bin2ai/Senior_Design/notes/ATMEGA328_Pinout_SeniorDesign.xlsx

ATMEGA328
PIPD |  |  | TQFP
# | type | our use | # | type | our use
1 | RESET | RESET | 1 | D | B en
2 | RXD | B TX | 2 | D | B Key
3 | TXD | B RX | 3 | GND | GND
4 | D | B en | 4 | VCC | VCC
5 | D | B state | 5 | GND | GND
6 | D | B Key | 6 | VCC | VCC
7 | VCC | VCC | 7 | XTAL | XTAL
8 | GND | GND | 8 | XTAL | XTAL
9 | OSC | OSC | 9 | D | LED Din
10 | OSC | OSC | 10 | D | Scale Dout
11 | D | Scale Dout | 11 | D | Scale clck
12 | D | Scale clck | 12 | D | touch
13 | D | touch | 13 | D | touch
14 | D | touch | 14 | D | touch
15 | D | touch | 15 | MOSI | ISP
16 | D | LED Din | 16 | MISO | ISP
17 | MOSI | ISP | 17 | SCK | ISP
18 | MISO | ISP | 18 | AVCC | AVCC
19 | SCK | ISP | 19 | ADC | ???
20 | VCC | VCC | 20 | AREF | AREF
21 | AREF | AREF | 21 | GND | GND
22 | GND | GND | 22 | ADC | motion
23 | ADC | motion | 23 | ADC | ambient
24 | ADC | ambient | 24 | ADC | current monitor
25 | ADC | current monitor | 25 | ADC | current monitor
26 | ADC | current monitor | 26 | ADC | ???
27 | SDA | LCD SDA | 27 | SDA | LCD SDA
28 | SCL | LCD SCL | 28 | SCL | LCD SCL
 |  |  | 29 | RESET | RESET
 |  |  | 30 | RX | B TX
 |  |  | 31 | TX | B RX
 |  |  | 32 | D | B state
