bin2ai/Senior_Design/screenshots/_12V_Power_4-24.GIF

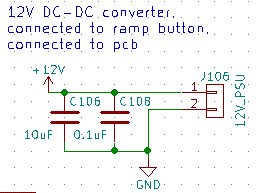
screenshots/_12V_Power_4-24.GIF
