bin2ai/Senior_Design/screenshots/Bluetooth_4-24.GIF

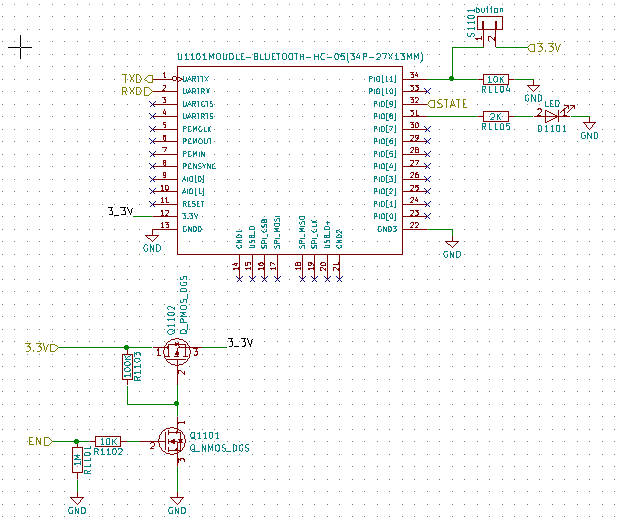
screenshots/Bluetooth_4-24.GIF
