bin2ai/Senior_Design/screenshots/buzzer_4-24.GIF

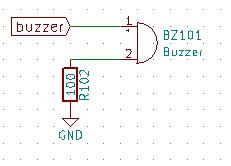
screenshots/buzzer_4-24.GIF
