bin2ai/Senior_Design/screenshots/CurrentSense_4-24.GIF

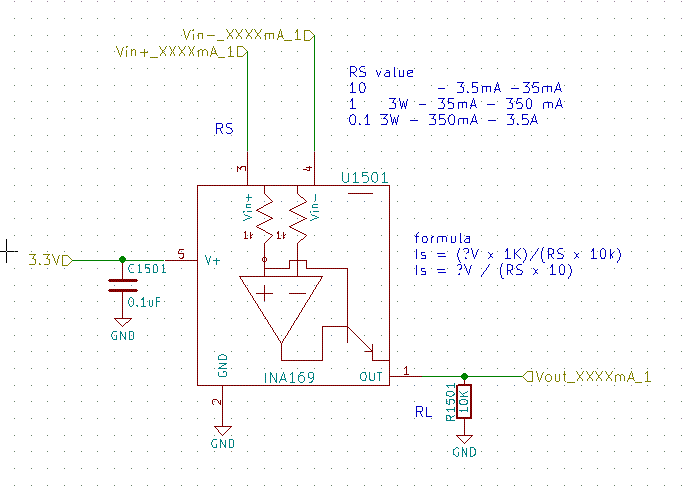
screenshots/CurrentSense_4-24.GIF
