bin2ai/Senior_Design/screenshots/ISP_4-24.GIF

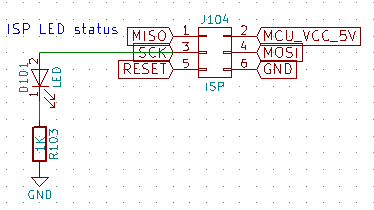
screenshots/ISP_4-24.GIF
