bin2ai/Senior_Design/screenshots/LCD_Display_4-24.GIF

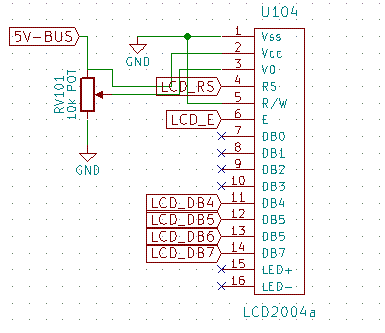
screenshots/LCD_Display_4-24.GIF
