bin2ai/Senior_Design/screenshots/LED_Single_4-24.GIF

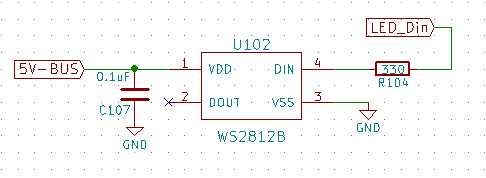
screenshots/LED_Single_4-24.GIF
