bin2ai/Senior_Design/screenshots/LED_Strip_4-24.GIF

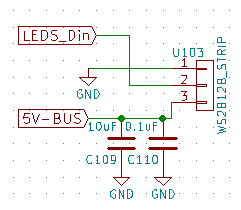
screenshots/LED_Strip_4-24.GIF
