bin2ai/Senior_Design/screenshots/loadCell_4-24.GIF

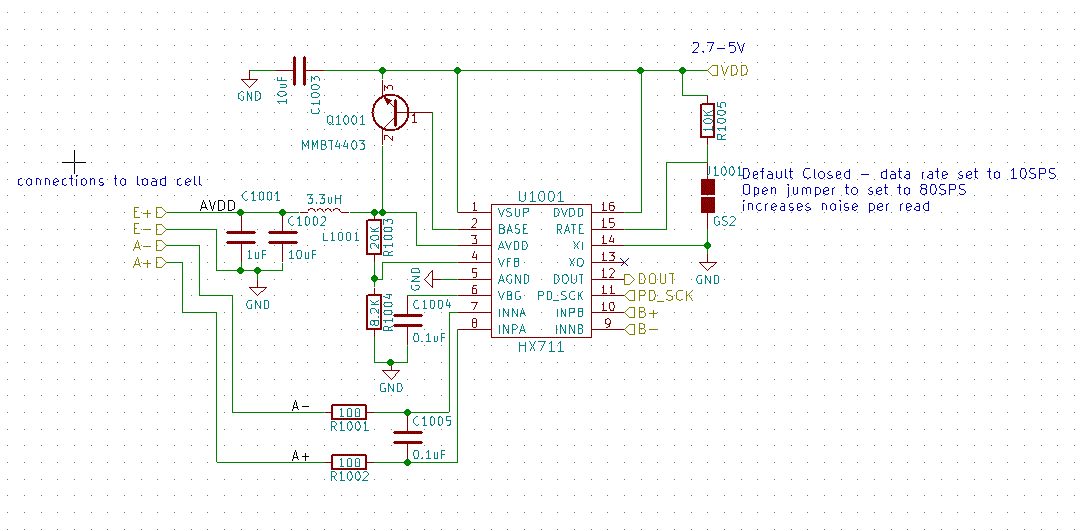
screenshots/loadCell_4-24.GIF
