bin2ai/Senior_Design/screenshots/MainSheet_4-24.GIF

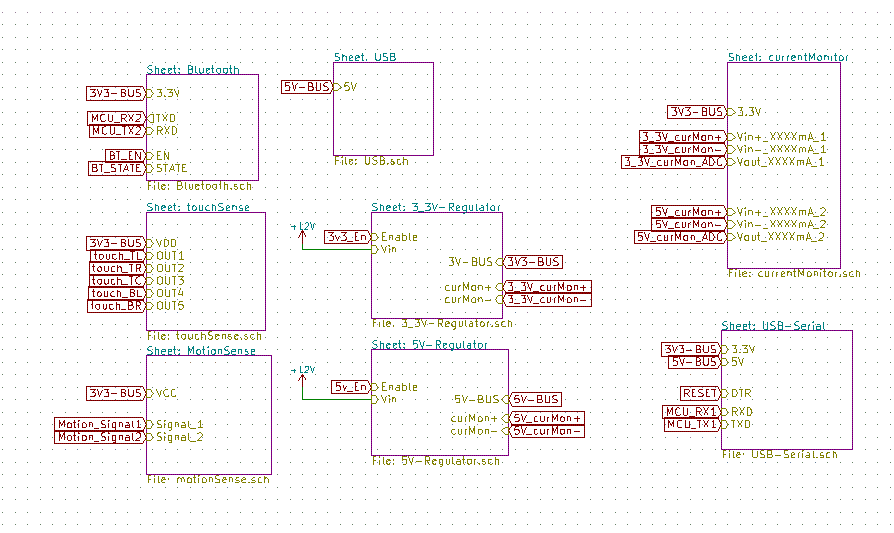
screenshots/MainSheet_4-24.GIF
