bin2ai/Senior_Design/screenshots/MCU_4-24.GIF

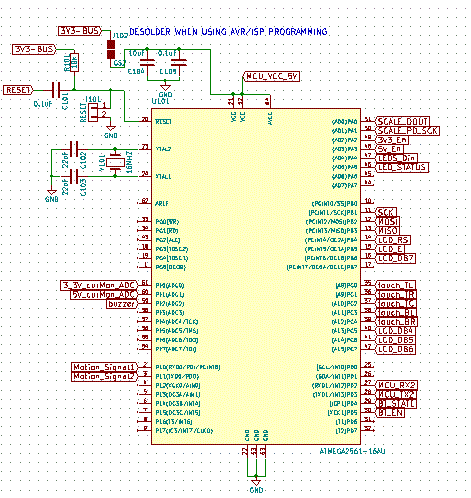
screenshots/MCU_4-24.GIF
