bin2ai/Senior_Design/screenshots/motionSense_4-24.GIF

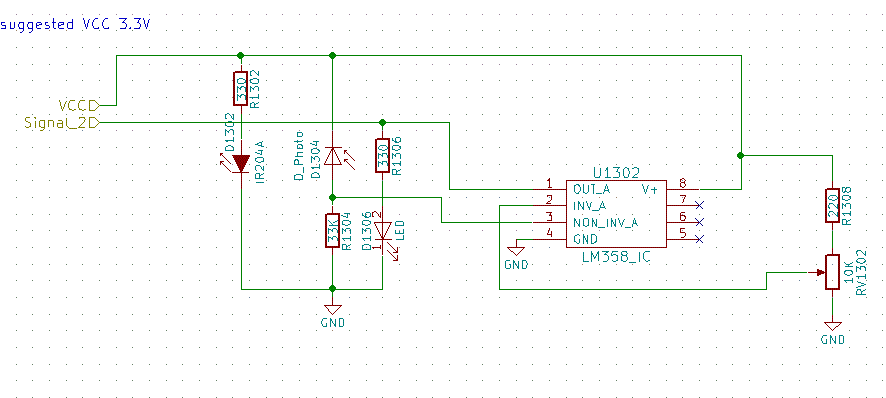
screenshots/motionSense_4-24.GIF
