bin2ai/Senior_Design/screenshots/power.GIF

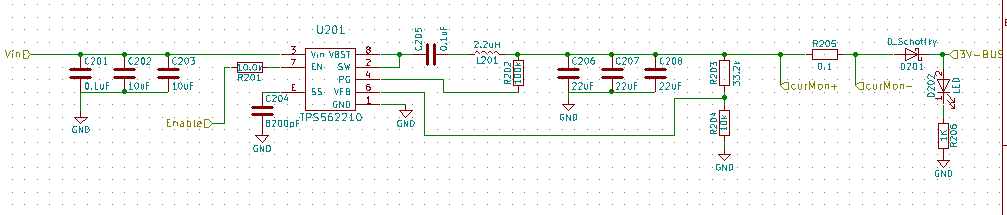
screenshots/power.GIF
