bin2ai/Senior_Design/screenshots/touchSense_HighLevel_4-24.GIF

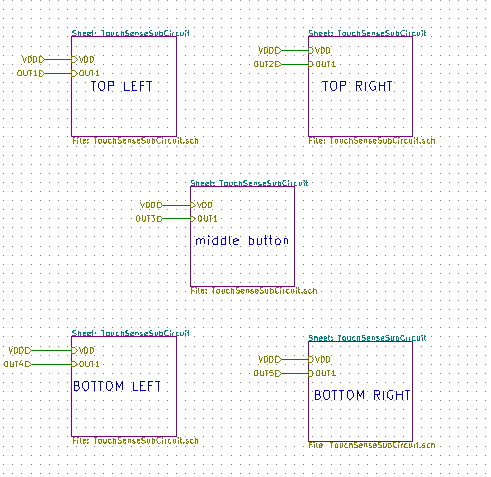
screenshots/touchSense_HighLevel_4-24.GIF
