bin2ai/Senior_Design/screenshots/touchSense_LowLevel_4-24.GIF

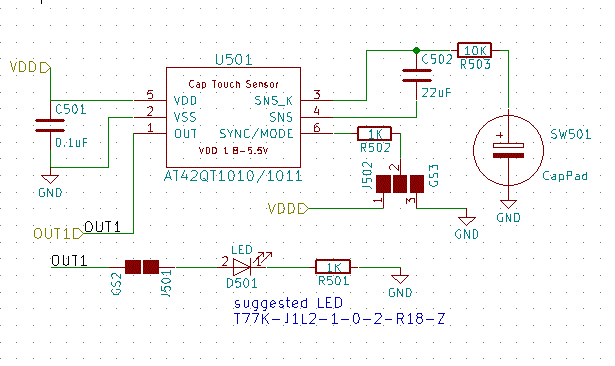
screenshots/touchSense_LowLevel_4-24.GIF
