bin2ai/Senior_Design/screenshots/USB_Out_4-24.GIF

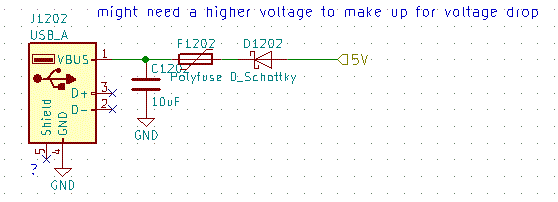
screenshots/USB_Out_4-24.GIF
