bin2ai/Senior_Design/screenshots/USB_Serial_4-24.GIF

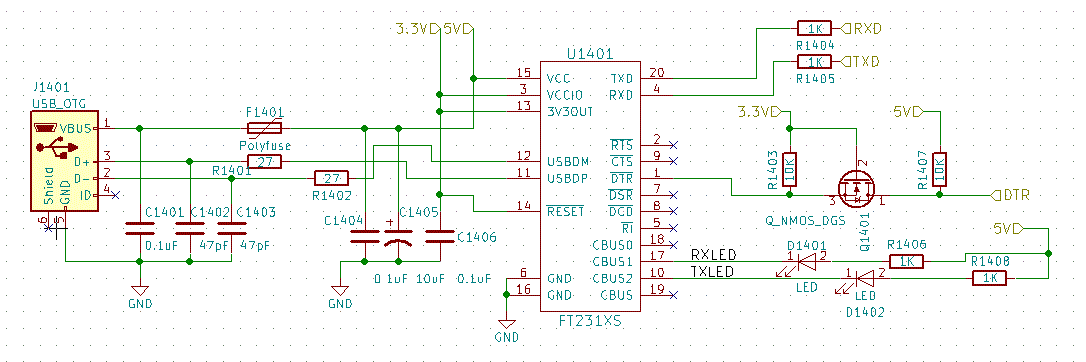
screenshots/USB_Serial_4-24.GIF
