bin2ai/Senior_Design/BOM/BOM_4-24.xlsx

BOM
# | Type | Value | PN | Notes | footprint | price | Dist. | Total | REF | QTY per Brd | footprint check | NOTES2
2 | C | 20pF | 0603YA200JAT2A (https://www.mouser.com/ProductDetail/AVX/0603YA200JAT2A?qs=sGAEpiMZZMs0AnBnWHyRQKdiqyDPVQdA6LLqx6KXMCE%3d) | 25VDC | 0603 | 0.29 | Mouser | 0.58
2 | C | 47pF | C0603C470K3RACTU (https://www.mouser.com/ProductDetail/KEMET/C0603C470K3RACTU) | 25VDC | 0603 | 0.24 | Mouser | 0.48
2 | C | 8200pF | VJ0603Y822MXXCW1BC (https://www.mouser.com/ProductDetail/Vishay-Vitramon/VJ0603Y822MXXCW1BC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) | 25VDC | 0603 | 0.1 | Mouser | 0.2
25 | C | 0.1uF | 885012206071 (https://www.mouser.com/ProductDetail/Wurth-Electronics/885012206071) | 25VDC | 0603 | 0.04 | Mouser | 1
2 | C | 1uF | 885012106022 (https://www.mouser.com/ProductDetail/Wurth-Electronics/885012106022) | 25VDC | 0603 | 0.09 | Mouser | 0.18
12 | C | 10uF | EMK212ABJ106MG-T (https://www.mouser.com/ProductDetail/Taiyo-Yuden/EMK212ABJ106MG-T) | 25VDC | 0805 | 0.18 | Mouser | 2.16 | C102 C103 C109 C110 C202 C203 C302 C305 C501 C502 C602 C603 | 12 | PASS | NEEDS 12 PER BOARD, NOT FOR ORDER (>12
12 | C | 22uF | GRM219R61C226ME15L (https://www.mouser.com/ProductDetail/Murata-Electronics/GRM219R61C226ME15L) | 25VDC | 0805 | 0.45 | Mouser | 5.4
4 | D | RED LED | AP2012EC (https://www.mouser.com/ProductDetail/Kingbright/AP2012EC) |  | 0805 | 0.13 | Mouser | 0.52
4 | D | GREEN LED | APT2012SGC (https://www.mouser.com/ProductDetail/Kingbright/APT2012SGC?qs=sGAEpiMZZMseGfSY3csMkeytxqHAv00AGb4ncJXLQok%3d) |  | 0805 | 0.14 | Mouser | 0.56
4 | D | YELLOW LED | APT2012YC (https://www.mouser.com/ProductDetail/Kingbright/APT2012YC) |  | 0805 | 0.13 | Mouser | 0.52
4 |  | White LED | HT-191TW (https://www.mouser.com/ProductDetail/Inolux/HT-191TW?qs=sGAEpiMZZMseGfSY3csMkY6I0nEzxA6OEbLdwesbyiw%3d) |  | 0603 | 0.17 | Mouser | 0.68
4 | D | Schottky | PMEG4020ER,115 (https://www.mouser.com/ProductDetail/Nexperia/PMEG4020ER115) | IF 2A | SOD-123 | 0.38 | Mouser | 1.52
4 | F | Poly-fuse | PTS12066V050 (https://www.mouser.com/ProductDetail/Nexperia/PMEG4020ER115) | H 0.5A, T 1A, 6V | 1206 | 0.3 | Mouser | 1.2
4 | Q | NFET | BSS138L (https://www.mouser.com/ProductDetail/ON-Semiconductor-Fairchild/BSS138L) |  | SOT-23 | 0.22 | Mouser | 0.88
2 | Q | PFET | RZM001P02T2L (https://www.mouser.com/ProductDetail/ROHM-Semiconductor/RZM001P02T2L) | low Ids 100mA | SOT-723-3 | 0.22 | Mouser | 0.44
2 | R | 0.1 | RL2512JK-070R1L (https://www.mouser.com/ProductDetail/Yageo/RL2512JK-070R1L) | current sense | 2512 | 0.58 | Mouser | 1.16
2 | R | 27 | CR1206-JW-270ELF (https://www.mouser.com/ProductDetail/Bourns/CR1206-JW-270ELF) | low cur. Rate. | 1206 | 0.1 | Mouser | 0.2
2 | R | 100 | RC1206FR-10100RL (https://www.mouser.com/ProductDetail/Yageo/RC1206FR-10100RL) | Ids 100mA | 1206 | 0.1 | Mouser | 0.2
2 | R | 220 | RC0603JR-10220RL (https://www.mouser.com/ProductDetail/Yageo/RC0603JR-10220RL) |  | 0603 | 0.01 | Mouser | 0.02
2 | R | 330 | RC0603JR-10330RL (https://www.mouser.com/ProductDetail/Yageo/RC0603JR-10330RL) |  | 0603 | 0.01 | Mouser | 0.02
2 | R | 500 | RN732ATTD5000B25 (https://www.mouser.com/ProductDetail/KOA-Speer/RN732ATTD5000B25) |  | 0805 | 0.71 | Mouser | 1.42
14 | R | 1K | CRCW04021K00FKEDC (https://www.mouser.com/ProductDetail/Vishay/CRCW04021K00FKEDC) | small package | 0402 | 0.1 | Mouser | 1.4
2 | R | 2K | RC0603JR-102KL (https://www.mouser.com/ProductDetail/Yageo/RC0603JR-102KL) |  | 0603 | 0.01 | Mouser | 0.02
2 | R | 8.2K | CRCW06038K20JNEA (https://www.mouser.com/ProductDetail/Vishay/CRCW06038K20JNEA) |  | 0603 | 0.1 | Mouser | 0.2
20 | R | 10K | CRCW040210K0FKEDC (https://www.mouser.com/ProductDetail/Vishay/CRCW040210K0FKEDC) | small package | 0402 | 0.1 | Mouser | 2
1 | R | 33.2K | RC0402FR-1333K2L (https://www.mouser.com/ProductDetail/Yageo/RC0402FR-1333K2L) |  | 0603 | 0.01 | Mouser | 0.01
1 | R | 54.9K | RC0603FR-1054K9L (https://www.mouser.com/ProductDetail/Yageo/RC0603FR-1054K9L) |  | 0603 | 0.01 | Mouser | 0.01
10 | R | 100K | ERJ-2GEJ104X (https://www.mouser.com/ProductDetail/Panasonic/ERJ-2GEJ104X) | small package | 0402 |  | Mouser | 0 | R104 R105 R202 R602 | ~4 | FAIL | two types of 100k on BOM
10 | R | 1M | CR0402-JW-105GLF (https://www.mouser.com/ProductDetail/Bourns/CR0402-JW-105GLF) | small package | 0402 | 0.1 | Mouser | 1
2 | RV | 10K | TC33X-2-103G (https://www.mouser.com/ProductDetail/Bourns/TC33X-2-103G?qs=sGAEpiMZZMvygUB3GLcD7vlYyyor7jZzTcLyrv4FnX8%3d) | potentiometer |  | 0.26 | Mouser | 0.52
1 | U | MCU | ATmega2560-16AU (https://www.mouser.com/ProductDetail/Microchip-Technology-Atmel/ATmega2560-16AU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) |  | TQFP-100 | 14.22 | Mouser | 14.22
1 | U | LED IC | WS2812B |  |  | 0.4 | Amazon | 0.4
1 | U | LCD | LCD2004a |  |  | 10 | Amazon | 10
2 | U | Regulator | TPS562210DDFR (https://www.mouser.com/ProductDetail/Texas-Instruments/TPS562210DDFR) |  | DDF(8) | 1.55 | Mouser | 3.1
5 | U | Touch Sensor | AT42QT1010-MAH (https://www.mouser.com/ProductDetail/Microchip-Technology/AT42QT1010-MAH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) |  | UDFN-8 | 0.6 | Mouser | 3
1 | U | amplifier | HX711 | IC / not board |  | 0.25 | Aliexpress | 0.25
1 | U | bluetooth | HC-05 | SMD board |  | 4 | Amazon | 4
2 | U | Dual OpAmp | LM358ADR (https://www.mouser.com/ProductDetail/Texas-Instruments/LM358ADR?qs=sGAEpiMZZMtYFXwiBRPs0zFXHJUd7gdT) |  | SOIC-8 | 0.36 | Mouser | 0.72
2 | U | Current Sense | INA169NA/3K (https://www.mouser.com/ProductDetail/Texas-Instruments/INA169NA-3K?qs=sGAEpiMZZMuo%252bmZx5g6tFD8TTXQDX2ot) |  | SOT-23-5 | 2.22 | Mouser | 4.44
1 | U | USB-Serial | FT231XS-R (https://www.mouser.com/ProductDetail/FTDI/FT231XS-R?qs=sGAEpiMZZMvVkErl6zY%252bqfBUiQa5NfR7) |  | SSOP-20 | 2.12 | Mouser | 2.12
1 | Y | crystal | LFXTAL033808Reel (https://www.mouser.com/ProductDetail/IQD/LFXTAL033808Reel) | 16MHz 20pF | HC-49-4 | 0.24 |  | 0.24
1 | BZ | buzzer | PS1240P02BT (https://www.mouser.com/ProductDetail/TDK/PS1240P02BT?qs=sGAEpiMZZMs%252b6Ea5iKw4JnKB8rEmL0Rz) | Vin 3V 4kHz | 12.2x6.5mm | 0.72 | Mouser | 0.72
 |  |  |  |  |  |  | Total | 67.71
missing components
1
2
3
4
5
6
7
8
9
10
11
