bin2ai/Senior_Design/notes/SeniorDesign_KiCadBom_MouserCart.xls

Sheet: Cart
 |  | key
 |  | watch video
 |  | cart footprint exists and bom DOES matches
 |  | cart footprint doesn't exists
 |  | cart footprint exists and bom DOESN’T matches
SHOPPING CART
This is not an invoice
07-Jun-18 03:43:58
 | Mouser # | Mfr. # | Manufacturer | Description | Order Qty. | Price (USD) | Ext.: (USD) | TRY TO MATCH WITH KICAD | PASS OR FAIL?
1 | 710-150060RS75000 | 150060RS75000 | Wurth Electronics | Standard LEDs - SMD WL-SMCW SMDMono TpVw Waterclr 0603 Red | 15 | $0.138 | $2.07 | LED R
2 | 710-150060GS75000 | 150060GS75000 | Wurth Electronics | Standard LEDs - SMD WL-SMCW SMDMono TpVw Waterclr 0603 Green | 15 | $0.138 | $2.07 | LED G
3 | 710-150060YS75000 | 150060YS75000 | Wurth Electronics | Standard LEDs - SMD WL-SMCW SMDMono TpVw Waterclr 0603 Yellow | 15 | $0.138 | $2.07 | LED Y
4 | 474-COM-13667 | COM-13667 | SparkFun Electronics | SparkFun Accessories SMD LED RGB WS2812B Strip of 10 | 1 | $4.95 | $4.95 | WS2812B S
5 | 474-COM-09806 | COM-09806 | SparkFun Electronics | SparkFun Accessories Trimpot 10K with Knob | 5 | $0.95 | $4.75 | R POT
6 | 556-ATMEGA328PB-AU | ATMEGA328PB-AU | Microchip | 8-bit Microcontrollers - MCU ATMEGA328PB 20MHZ IND TEMP | 10 | $1.48 | $14.80 | ATMEGA328PB
7 | 611-JS202011SCQN | JS202011SCQN | C&K Switches | Slide Switches DPDT SMT .3A | 5 | $0.44 | $2.20 | DPDT SWITCH
8 | 595-INA169NA/3K | INA169NA/3K | Texas Instruments | Current & Power Monitors & Regulators Hi-Sd Msmnt Current Shunt Mntr Crnt Otp | 10 | $1.87 | $18.70 | R SHUNT
9 | 595-LM358ADR | LM358ADR | Texas Instruments | Operational Amplifiers - Op Amps Dual Op Amp | 5 | $0.36 | $1.80 | LM358
10 | 595-LP2985-33DBVR | LP2985-33DBVR | Texas Instruments | LDO Voltage Regulators 150-mA Low-Noise 1.5% tolerance | 5 | $0.58 | $2.90 | LP2985-33
11 | 559-FOXS160-20-LF | FOXSLF/160-20 | Fox | Crystals 16MHz 20pF | 5 | $0.31 | $1.55 | CRSYTAL
12 | 474-COM-00097 | COM-00097 | SparkFun Electronics | SparkFun Accessories Mini Pushbutton Switch | 10 | $0.35 | $3.50 | BUTTON
13 | 595-TPS563210ADDFT | TPS563210ADDFT | Texas Instruments | Switching Voltage Regulators 17V Input, 3A Synchronous Step-Down Regulator in SOT-23 w/ Advanced Eco-mode, PG, Soft Start 8-SOT-23-THIN -40 to 85 | 10 | $1.40 | $14.00 | TPS563210
14 | 755-RSX301LAM30TR | SRN5040-4R7M | ROHM Semiconductor | Schottky Diodes & Rectifiers 30V Vr 0.09mA IR Schottky Br Diode | 15 | $0.292 | $4.38 | SCHOTTKY DIODE
15 | 504-PTS120615V050 | PTS120615V050 | Eaton | Resettable Fuses - PPTC PPTC 1206 15V 0.5A SMD | 10 | $0.253 | $2.53 | FUSE
16 | 512-MMBT4403 | MMBT4403 | ON Semiconductor | Bipolar Transistors - BJT SOT-23 PNP GEN PUR | 5 | $0.22 | $1.10 | MMBT4403
17 | 512-BSS138L | BSS138L | ON Semiconductor | MOSFET FET 50V 3.5 OHM SOT23 | 10 | $0.15 | $1.50 | BSS138L
18 | 652-SRN5040-4R7M | SRN5040-4R7M | Bourns | Fixed Inductors 4.7uH 20% SMD 5040 | 10 | $0.246 | $2.46 | 4.7uH
19 | 810-KLZ2012MHR3R3HTD | KLZ2012MHR3R3HTD25 | TDK | Fixed Inductors 3.3uH 2MHz 20% 2012 AEC-Q200 | 5 | $0.22 | $1.10 | 3.3uH
20 | 279-2-2176055-5 | 2-2176055-5 | TE Connectivity | Current Sense Resistors - SMD 2B R10 1% 1K RL | 10 | $0.088 | $0.88 | R VALUE?
21 | 81-GRT033R60J104KE1D | GRT033R60J104KE01D | Murata | Multilayer Ceramic Capacitors MLCC - SMD/SMT | 100 | $0.022 | $2.20 | C VALUE?
22 | 80-C0603C105K9PAC | C0603C105K9PAC | KEMET | Multilayer Ceramic Capacitors MLCC - SMD/SMT 6.3volts 1uF 10% X5R | 100 | $0.027 | $2.70 | 1uF
23 | 963-LMK212BBJ226MG-T | LMK212BBJ226MG-T | Taiyo Yuden | Multilayer Ceramic Capacitors MLCC - SMD/SMT 22uF 10V X5R +/-20% 0805 Gen Purp | 30 | $0.125 | $3.75 | 22uF 10V X5R +/-20
24 | 963-EMK212ABJ106MG-T | EMK212ABJ106MG-T | Taiyo Yuden | Multilayer Ceramic Capacitors MLCC - SMD/SMT 10uF 16V X5R 20% 0805 | 100 | $0.05 | $5.00 | 10uF 16V
25 | 80-C0402C822K5R | C0402C822K5RACTU | KEMET | Multilayer Ceramic Capacitors MLCC - SMD/SMT 50volts 8200pF X7R 10% | 10 | $0.023 | $0.23 | 50volts 8200pF
26 | 81-GRM0335C1E200GA1D | GRM0335C1E200GA01D | Murata | Multilayer Ceramic Capacitors MLCC - SMD/SMT 0201 20pF 25volts C0G +/-2% | 10 | $0.019 | $0.19 | 0201 20pF
27 | 710-694106301002 | 694106301002 | Wurth Electronics | DC Power Connectors WR-DC PwrJk CtrPnTHT Right Angled | 5 | $1.04 | $5.20 | Connectors WR-DC PwrJk
28 | 279-CPF0603B59KE1 | CPF0603B59KE1 | TE Connectivity | Thin Film Resistors - SMD CPF 0603 59K 0.1% 25PPM 1K RL | 10 | $0.18 | $1.80 | 0603 59K 0.1
29 | 284-APC0603B10K0N | APC0603B10K0N | Ohmite | Thin Film Resistors - SMD 10KOhm 0.1% 0603 25 PPM | 10 | $0.086 | $0.86 | 10KOhm 0.1
30 | 754-RR0816P-103D | RR0816P-103-D | Susumu | Thin Film Resistors - SMD 1/16W 10Kohm 0.5% 25ppm | 100 | $0.02 | $2.00 | 1/16W 10Kohm
31 | 603-RT1206FRE07499RL | RT1206FRE07499RL | Yageo | Thin Film Resistors - SMD 1/4W 499 ohm 1% 50ppm | 100 | $0.026 | $2.60 | 1/4W 499 ohm
32 | 71-CRCW0603J-8.2K-E3 | CRCW06038K20JNEA | Vishay | Thick Film Resistors - SMD 1/10watt 8.2Kohms 5% | 10 | $0.031 | $0.31 | 1/10watt 8.2Kohms
33 | 71-CRCW06038K20FKEAC | CRCW06038K20FKEAC | Vishay | Thick Film Resistors - SMD 1/10Watt 8.2Kohms 1% Commercial Use | 10 | $0.042 | $0.42 | 1/10Watt 8.2Kohms
34 | 603-AC0603FR-0720KL | AC0603FR-0720KL | Yageo | Thick Film Resistors - SMD 1/10W 20K ohm 1% AEC-Q200 | 10 | $0.016 | $0.16 | 1/10W 20K ohm
35 | 755-ESR03EZPJ103 | ESR03EZPJ103 | ROHM Semiconductor | Thick Film Resistors - SMD 0603 10Kohm 5% Anti Surge AEC-Q200 | 100 | $0.025 | $2.50 | 0603 10Kohm 5% Anti
36 | 71-CRCW0603100KFKEAC | CRCW0603100KFKEAC | Vishay | Thick Film Resistors - SMD 1/10Watt 100Kohms 1% Commercial Use | 100 | $0.024 | $2.40 | 1/10Watt 100Kohms
By submitting your order you agree to these terms and conditions. (https://www.mouser.com/saleterms) |  |  |  |  |  | Merchandise Total: | $121.63
Prices are reflected at the date and time shown. |  |  |  |  |  | Shipping Charge: | Estimate
 |  |  |  |  |  | Backorder Shipping: | Estimate

Sheet: BOM
Ref | Qty | Value | Footprint | P/N | NOTES:
C102 C103 C109 C110 C202 C203 C302 C305 C501 C502 C602 C603 | 12 | 10uF | Capacitors_SMD:C_0805 | EMK212ABJ106MG-T
C104 C106 C108 C111 C201 C205 C301 C303 C304 C306 C601 C605 C901 C1001 C1101 C1103 C1104 | 17 | 0.1uF | Capacitors_SMD:C_0603
C107 | 1 | 10uF | Capacitors_SMD:C_0805
C112 C113 | 2 | 20pF | Capacitors_SMD:C_0603 | GRM0335C1E200GA01D
C114 | 1 | ?uF | Capacitors_THT:CP_Radial_D10.0mm_P5.00mm | EMK212ABJ106MG-T
C204 C604 | 2 | 8200pF | Capacitors_SMD:C_0402 | C0402C822K5RACTU
C206 C208 C606 C608 | 4 | 22uF | Capacitors_SMD:C_0805
C207 C607 | 2 | 22uF | Capacitors_SMD:C_0805 | LMK212BBJ226MG-T
C1102 | 1 | 1uF | Capacitors_SMD:C_0603 | C0603C105K9PAC
C1105 | 1 | 1uF | Capacitors_SMD:C_0603
D101 D102 D103 D104 D105 D106 D401 D1103 D1105 | 9 | LED | LEDs:LED_0603
D201 D601 D1104 | 3 | D_Schottky | sod:SOD-128 | RSX301LAM30TR
D501 D502 | 2 | D_Schottky | sod:SOD-128 | 755-RSX301LAM30TR
D1101 | 1 | IR204A | LEDs:LED_D5.0mm_Horizontal_O3.81mm_Z3.0mm
D1102 | 1 | D_Photo | LEDs:LED_D1.8mm_W1.8mm_H2.4mm_Horizontal_O3.81mm_Z4.9mm
F501 F502 | 2 | Polyfuse | Fuse_Holders_and_Fuses:Fuse_SMD1206_Reflow | PTS120615V050
J101 | 1 | BARREL_JACK | Connectors:Barrel_Jack_CUI_PJ-102AH | 694106301002
J102 | 1 | touch(8pos) | Pin_Headers:Pin_Header_Straight_2x04_Pitch2.54mm
J103 | 1 | ISP | Pin_Headers:Pin_Header_Straight_2x03_Pitch2.54mm
J104 J105 J106 J110 J117 J118 | 6 | GS3 | Connectors:GS3
J107 | 1 | LoadCell_Conn | Pin_Headers:Pin_Header_Straight_1x04_Pitch2.54mm
J108 | 1 | Smraza2004_LCD | Pin_Headers:Pin_Header_Straight_1x04_Pitch2.54mm
J109 | 1 | ambientLight | Pin_Headers:Pin_Header_Straight_1x03_Pitch2.54mm
J112 | 1 | Serial Monitor | Pin_Headers:Pin_Header_Straight_2x01_Pitch2.54mm
J113 | 1 | breakout | Pin_Headers:Pin_Header_Straight_1x04_Pitch2.54mm
J119 | 1 | ext_5VPWR | Pin_Headers:Pin_Header_Straight_1x04_Pitch2.54mm
J123 J301 J302 J401 J402 J1102 J1103 | 7 | GS2 | Connectors:GS2
J124 | 1 | ext_Motion | Pin_Headers:Pin_Header_Straight_1x03_Pitch2.54mm
J501 J502 | 2 | USB_A | Connectors:USB_A | SS-52100-001
L201 L601 | 2 | 4.7uH | Inductors_SMD:L_Taiyo-Yuden_MD-5050 | SRN5040-4R7M
L301 | 1 | 3.3uH | Inductors_SMD:L_0805 | KLZ2012MHR3R3HTD25
MH101 MH102 MH103 MH104 | 4 | Mounting Hole | Connectors:Pin_d1.3mm_L11.0mm
Q301 | 1 | MMBT4403 | sot:SOT23 | MMBT4403
Q1101 Q1102 | 2 | BSS138 | TO_SOT_Packages_SMD:SOT-23 | BSS138L
R101 | 1 | 500 | Resistors_SMD:R_0805_HandSoldering | RT1206FRE07499RL
R102 R103 R107 R108 R109 R110 R406 R1102 R1104 R1112 R1113 | 11 | 500 | Resistors_SMD:R_0805_HandSoldering
R104 R105 | 2 | 100K | Resistors_SMD:R_0603
R106 R701 R702 R703 R704 R1101 | 6 | 10k | Resistors_SMD:R_0603
R201 R601 | 2 | 10k | Resistors_SMD:R_0603 | ESR03EZPJ103
R202 R602 | 2 | 100k | Resistors_SMD:R_0603
R203 R603 | 2 | 59k | Resistors_SMD:R_0603 | CPF0603B59KE1
R204 R604 | 2 | 10k_FB | Resistors_SMD:R_0603 | APC0603B10K0N
R205 R605 | 2 | 0.1_SHUNT | Resistors_SMD:R_1206 | 2-2176055-5
R301 R302 R1105 | 3 | 100 | Resistors_SMD:R_0805_HandSoldering
R303 | 1 | 20K | Resistors_SMD:R_0603 | AC0603FR-0720KL
R304 | 1 | 8.2K | Resistors_SMD:R_0603 | CRCW06038K20FKEAC
R305 R901 R1001 R1106 R1108 R1109 R1110 R1111 | 8 | 10K | Resistors_SMD:R_0603
R405 | 1 | 10K | Resistors_SMD:R_0603 | RR0816P-103-D
R801 R902 | 2 | 10 | Resistors_THT:R_Axial_DIN0309_L9.0mm_D3.2mm_P5.08mm
R802 R903 | 2 | RL | Resistors_THT:R_Axial_DIN0309_L9.0mm_D3.2mm_P5.08mm
R1103 | 1 | 54.9K | Resistors_SMD:R_0603
R1107 | 1 | 100K | Resistors_SMD:R_0603 | CRCW0603100KFKEAC
RV1101 | 1 | 10K | SparkFun-Electromechanical:TSR-3386U
SW101 | 1 | Serial Switch | Buttons_Switches_THT:SW_CuK_JS202011CQN_DPDT_Straight | JS202011SCQN
SW102 | 1 | RESET | Buttons_Switches_THT:SW_PUSH_6mm | COM-00097
SW1101 | 1 | BLE_RESET | Buttons_Switches_THT:SW_PUSH_6mm
U102 | 1 | WS2812B | LEDs:LED_WS2812B-PLCC4 | 474-COM-13667
U103 | 1 | WS2812B_STRIP | Pin_Headers:Pin_Header_Straight_1x03_Pitch2.54mm
U104 | 1 | ATMEGA328PB-AU | Housings_QFP:TQFP-32_7x7mm_Pitch0.8mm | ATMEGA328PB-AU
U201 U601 | 2 | TPS563210ADDFT | TO_SOT_Packages_SMD:SOT-23-8 | TPS563210ADDFT
U301 | 1 | HX711 | soic:SOIC16 | missing
U401 | 1 | HC-05(34P-27X13MM) | Bluetooth:HC-05, SOIC-14 | Missing
U901 U1001 | 2 | INA169 | TO_SOT_Packages_SMD:SOT-23-5 | INA169NA/3K
U1101 | 1 | LM358_IC | soic:SOIC8 | LM358ADR
U1102 | 1 | LP2985-3.3 | TO_SOT_Packages_SMD:SOT-23-5 | LP2985-33DBVR
Y101 | 1 | 16MHZ | Crystals:Crystal_HC49-U_Vertical | FOXSLF/160-20
