bin2ai/Senior_Design/notes/Cart_Jun09_0148PM.xls

SHOPPING CART
This is not an invoice
09-Jun-18 13:48:12
 | Mouser # | Mfr. # | Manufacturer | Customer # | Description | RoHS | Lifecycle | Order Qty. | Price (USD) | Ext.: (USD)
1 | 81-GRM39Y104Z25D | GRM188F51E104ZA01D | Murata |  | Multilayer Ceramic Capacitors MLCC - SMD/SMT RECOMMENDED ALT 81-GRM188R61E104KA1D | RoHS Compliant | NRND | 100 | $0.02 | $2.00
2 | 81-GRM0335C1E200GA1D | GRM0335C1E200GA01D | Murata |  | Multilayer Ceramic Capacitors MLCC - SMD/SMT 0201 20pF 25volts C0G +/-2% | RoHS Compliant |  | 100 | $0.009 | $0.90
3 | 80-C0402C822K5R | C0402C822K5RACTU | KEMET |  | Multilayer Ceramic Capacitors MLCC - SMD/SMT 50volts 8200pF X7R 10% | RoHS Compliant |  | 100 | $0.014 | $1.40
4 | 710-150060RS75000 | 150060RS75000 | Wurth Electronics |  | Standard LEDs - SMD WL-SMCW SMDMono TpVw Waterclr 0603 Red | RoHS Compliant |  | 20 | $0.138 | $2.76
5 | 710-150060YS75000 | 150060YS75000 | Wurth Electronics |  | Standard LEDs - SMD WL-SMCW SMDMono TpVw Waterclr 0603 Yellow | RoHS Compliant |  | 15 | $0.138 | $2.07
6 | 710-150060GS75000 | 150060GS75000 | Wurth Electronics |  | Standard LEDs - SMD WL-SMCW SMDMono TpVw Waterclr 0603 Green | RoHS Compliant |  | 10 | $0.138 | $1.38
7 | 755-RSX301LAM30TR | RSX301LAM30TR | ROHM Semiconductor |  | Schottky Diodes & Rectifiers 30V Vr 0.09mA IR Schottky Br Diode | RoHS Compliant | New Product | 30 | $0.292 | $8.76
8 | 504-PTS120615V050 | PTS120615V050 | Eaton |  | Resettable Fuses - PPTC PPTC 1206 15V 0.5A SMD | RoHS Compliant |  | 10 | $0.253 | $2.53
9 | 710-694106301002 | 694106301002 | Wurth Electronics |  | DC Power Connectors WR-DC PwrJk CtrPnTHT Right Angled | RoHS Compliant |  | 5 | $1.04 | $5.20
10 | 530-SS-52100-001 | SS-52100-001 | Bel |  | USB Connectors USB 2.0 R Angle Recpt Type A solder | RoHS Compliant | New Product | 10 | $0.391 | $3.91
11 | 652-SRN5040-4R7M | SRN5040-4R7M | Bourns |  | Fixed Inductors 4.7uH 20% SMD 5040 | RoHS Compliant |  | 10 | $0.246 | $2.46
12 | 810-KLZ2012MHR3R3HTD | KLZ2012MHR3R3HTD25 | TDK |  | Fixed Inductors 3.3uH 2MHz 20% 2012 AEC-Q200 | RoHS Compliant | New Product | 10 | $0.152 | $1.52
13 | 512-MMBT4403 | MMBT4403 | ON Semiconductor |  | Bipolar Transistors - BJT SOT-23 PNP GEN PUR | RoHS Compliant | End of Life | 10 | $0.144 | $1.44
14 | 512-BSS138L | BSS138L | ON Semiconductor |  | MOSFET FET 50V 3.5 OHM SOT23 | RoHS Compliant |  | 100 | $0.063 | $6.30
15 | 754-RR1220P-511D | RR1220P-511-D | Susumu |  | Thin Film Resistors - SMD 1/10W 510ohm 0.5% 25ppm | RoHS Compliant |  | 100 | $0.03 | $3.00
16 | 755-ESR03EZPJ103 | ESR03EZPJ103 | ROHM Semiconductor |  | Thick Film Resistors - SMD 0603 10Kohm 5% Anti Surge AEC-Q200 | RoHS Compliant |  | 100 | $0.025 | $2.50
17 | 71-CRCW0603100KFKEAC | CRCW0603100KFKEAC | Vishay |  | Thick Film Resistors - SMD 1/10Watt 100Kohms 1% Commercial Use | RoHS Compliant By Exemption | New Product | 100 | $0.024 | $2.40
18 | 279-CPF0603B59KE1 | CPF0603B59KE1 | TE Connectivity |  | Thin Film Resistors - SMD CPF 0603 59K 0.1% 25PPM 1K RL | RoHS Compliant |  | 15 | $0.18 | $2.70
19 | 284-APC0603B10K0N | APC0603B10K0N | Ohmite |  | Thin Film Resistors - SMD 10KOhm 0.1% 0603 25 PPM | RoHS Compliant |  | 10 | $0.086 | $0.86
20 | 279-2-2176055-5 | 2-2176055-5 | TE Connectivity |  | Current Sense Resistors - SMD 2B R10 1% 1K RL | RoHS Compliant |  | 10 | $0.088 | $0.88
21 | 755-ESR10EZPJ101 | ESR10EZPJ101 | ROHM Semiconductor |  | Thick Film Resistors - SMD 0805 100ohm 5% Anti Surge AEC-Q200 | RoHS Compliant |  | 15 | $0.071 | $1.07
22 | 474-COM-09806 | COM-09806 | SparkFun Electronics |  | SparkFun Accessories Trimpot 10K with Knob |  | New At Mouser | 5 | $0.95 | $4.75
23 | 611-JS202011SCQN | JS202011SCQN | C&K Switches |  | Slide Switches DPDT SMT .3A | RoHS Compliant |  | 5 | $0.44 | $2.20
24 | 474-COM-00097 | COM-00097 | SparkFun Electronics |  | SparkFun Accessories Mini Pushbutton Switch | RoHS Compliant | New At Mouser | 10 | $0.35 | $3.50
25 | 556-ATMEGA328PB-AU | ATMEGA328PB-AU | Microchip |  | 8-bit Microcontrollers - MCU ATMEGA328PB 20MHZ IND TEMP | RoHS Compliant |  | 10 | $1.48 | $14.80
26 | 595-TPS563210ADDFT | TPS563210ADDFT | Texas Instruments |  | Switching Voltage Regulators 17V Input, 3A Synchronous Step-Down Regulator in SOT-23 w/ Advanced Eco-mode, PG, Soft Start 8-SOT-23-THIN -40 to 85 | RoHS Compliant | New Product | 10 | $1.40 | $14.00
27 | 595-INA169NA/3K | INA169NA/3K | Texas Instruments |  | Current & Power Monitors & Regulators Hi-Sd Msmnt Current Shunt Mntr Crnt Otp | RoHS Compliant |  | 10 | $1.87 | $18.70
28 | 595-LM358ADR | LM358ADR | Texas Instruments |  | Operational Amplifiers - Op Amps Dual Op Amp | RoHS Compliant |  | 5 | $0.36 | $1.80
29 | 595-LP2985-33DBVR | LP2985-33DBVR | Texas Instruments |  | LDO Voltage Regulators 150-mA Low-Noise 1.5% tolerance | RoHS Compliant |  | 5 | $0.58 | $2.90
30 | 559-FOXS160-20-LF | FOXSLF/160-20 | Fox |  | Crystals 16MHz 20pF | RoHS Compliant |  | 5 | $0.31 | $1.55
31 | 810-C2012X6S1C685M2A | C2012X6S1C685M125AC | TDK |  | Multilayer Ceramic Capacitors MLCC - SMD/SMT 0805 16V 6.8uF X6S 20% T: 1.25mm | RoHS Compliant |  | 10 | $0.385 | $3.85
32 | 81-GRM21BR71A106MA3K | GRM21BR71A106MA73K | Murata |  | Multilayer Ceramic Capacitors MLCC - SMD/SMT 0805 10uF 10volts *Derate Voltage/Temp | RoHS Compliant |  | 100 | $0.075 | $7.50
By submitting your order you agree to these terms and conditions. (https://www.mouser.com/saleterms) |  |  |  |  |  |  |  |  | Merchandise Total: | $131.59
Prices are reflected at the date and time shown. |  |  |  |  |  |  |  |  | Shipping Charge: | Estimate
