bin2ai/Senior_Design/notes/waiterPCB1.dxf

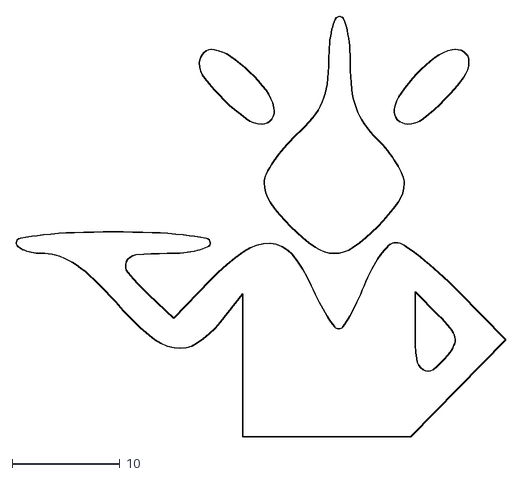
[picture p20: CAD file, 2018-06-08]
notes/waiterPCB1.dxf
45.4 x 39.0
