bin2ai/Senior_Design/screenshots/waiterPCB.dxf

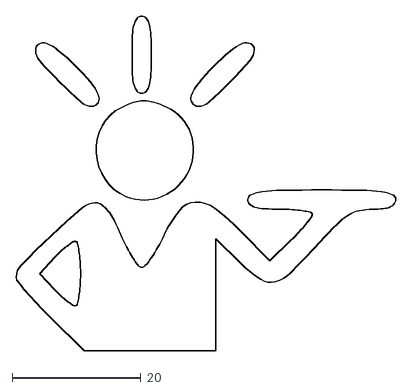
[picture p21: CAD file, 2018-06-07]
screenshots/waiterPCB.dxf
59.0 x 52.0
