bin2ai/Senior_Design/notes/Zone-Capactive-Touch3_r2.dxf

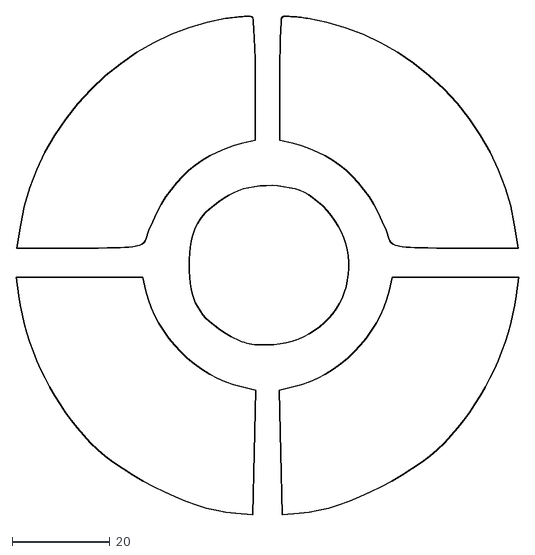
[picture p22: CAD file, 2018-06-08]
notes/Zone-Capactive-Touch3_r2.dxf
102.7 x 101.9
