bin2ai/Senior_Design/notes/waiterPCB2.dxf

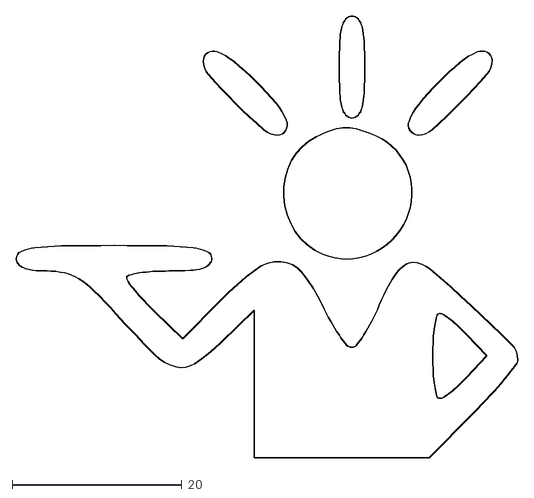
[picture p23: CAD file, 2018-06-08]
notes/waiterPCB2.dxf
59.0 x 52.0
