bin2ai/Senior_Design/notes/Zone-Capactive-Touch3_r1.dxf

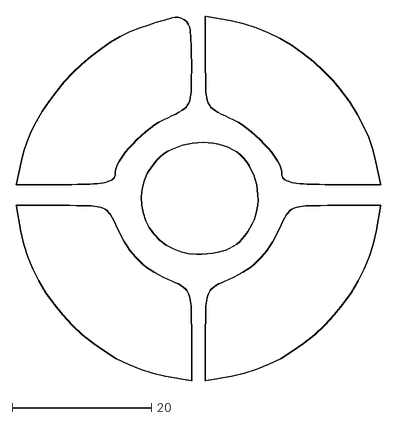
[picture p24: CAD file, 2018-06-08]
notes/Zone-Capactive-Touch3_r1.dxf
52.4 x 52.4
