bin2ai/Senior_Design/notes/Zone-Capactive-Touch3_r3.dxf

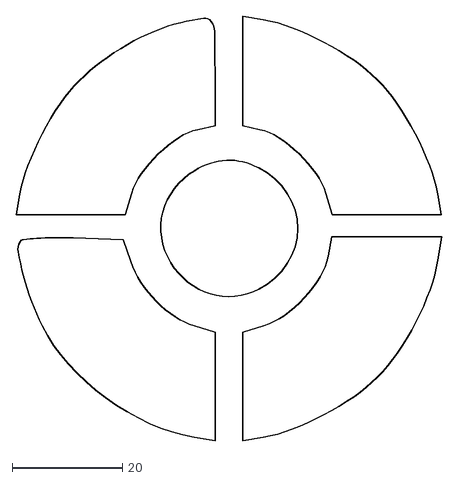
[picture p25: CAD file, 2018-06-08]
notes/Zone-Capactive-Touch3_r3.dxf
77.3 x 77.2
