bin2ai/Senior_Design/notes/Zone-Capactive-Touch3.dxf

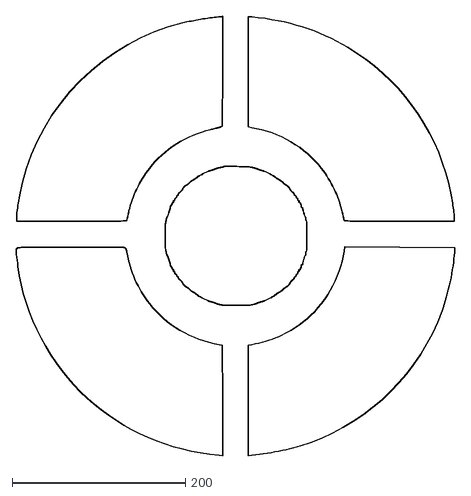
[picture p26: CAD file, 2018-06-08]
notes/Zone-Capactive-Touch3.dxf
506.9 x 507.5
