bin2ai/Senior_Design/touchSense.kicad_pcb

## KiCad design touchSense.kicad_pcb (2018-06-17)

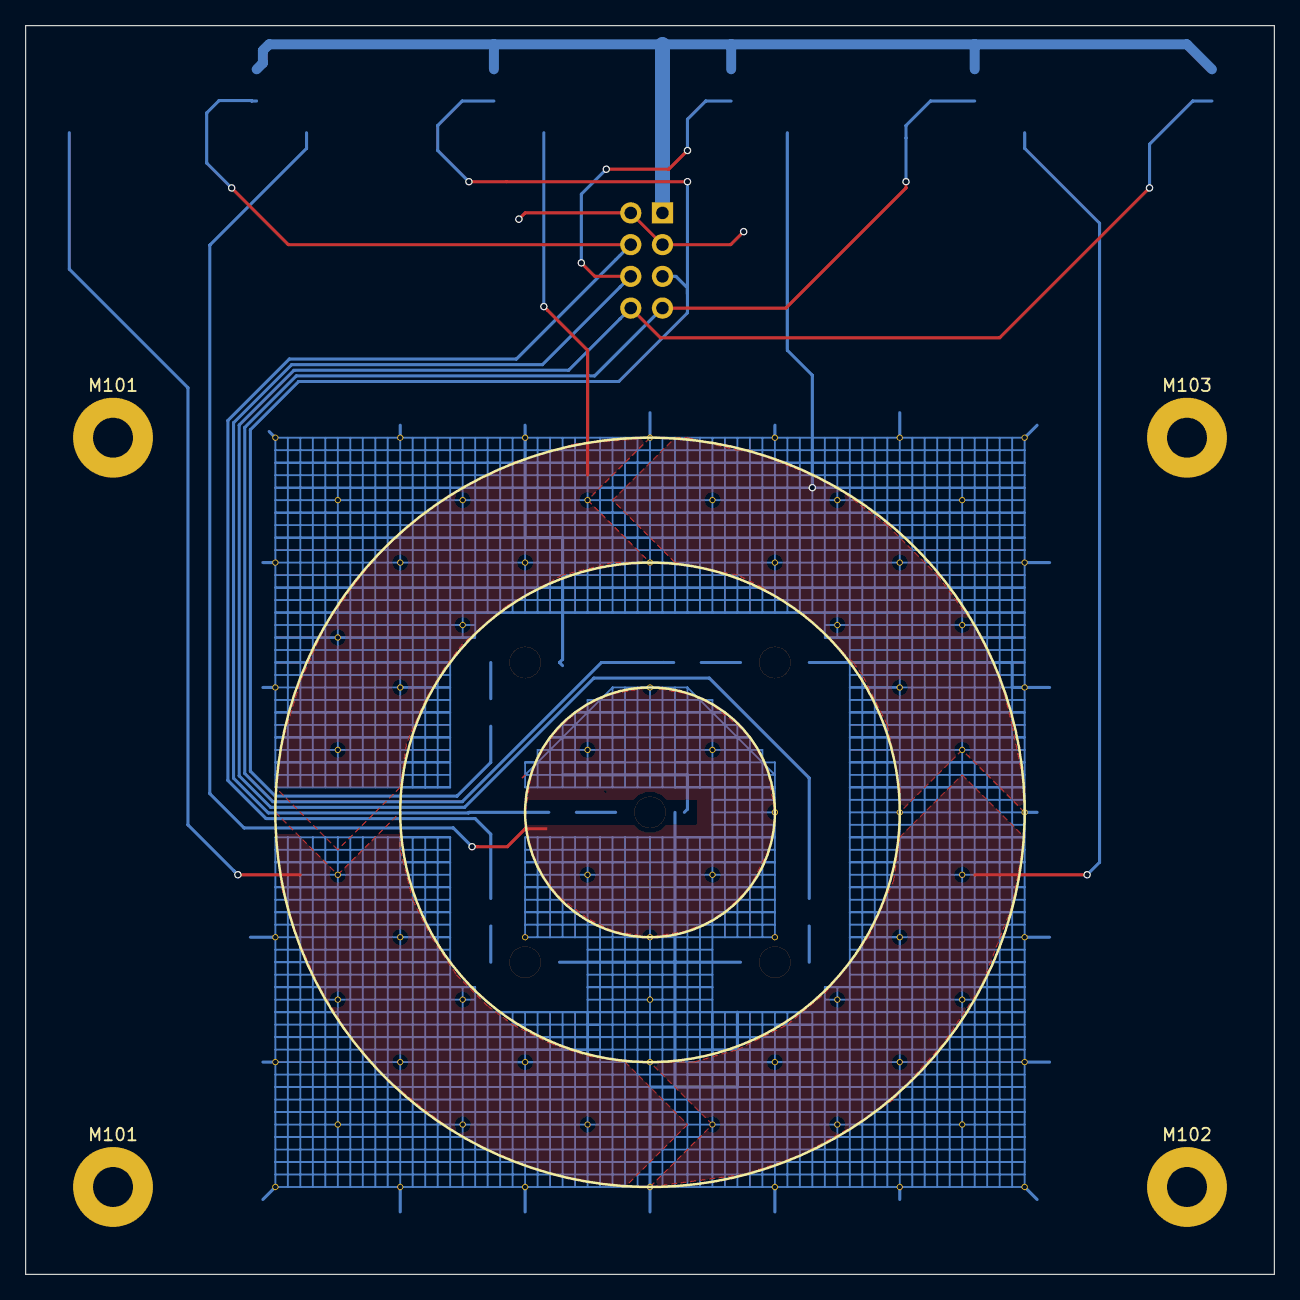
[picture p27: board touchSense.kicad_pcb from above]

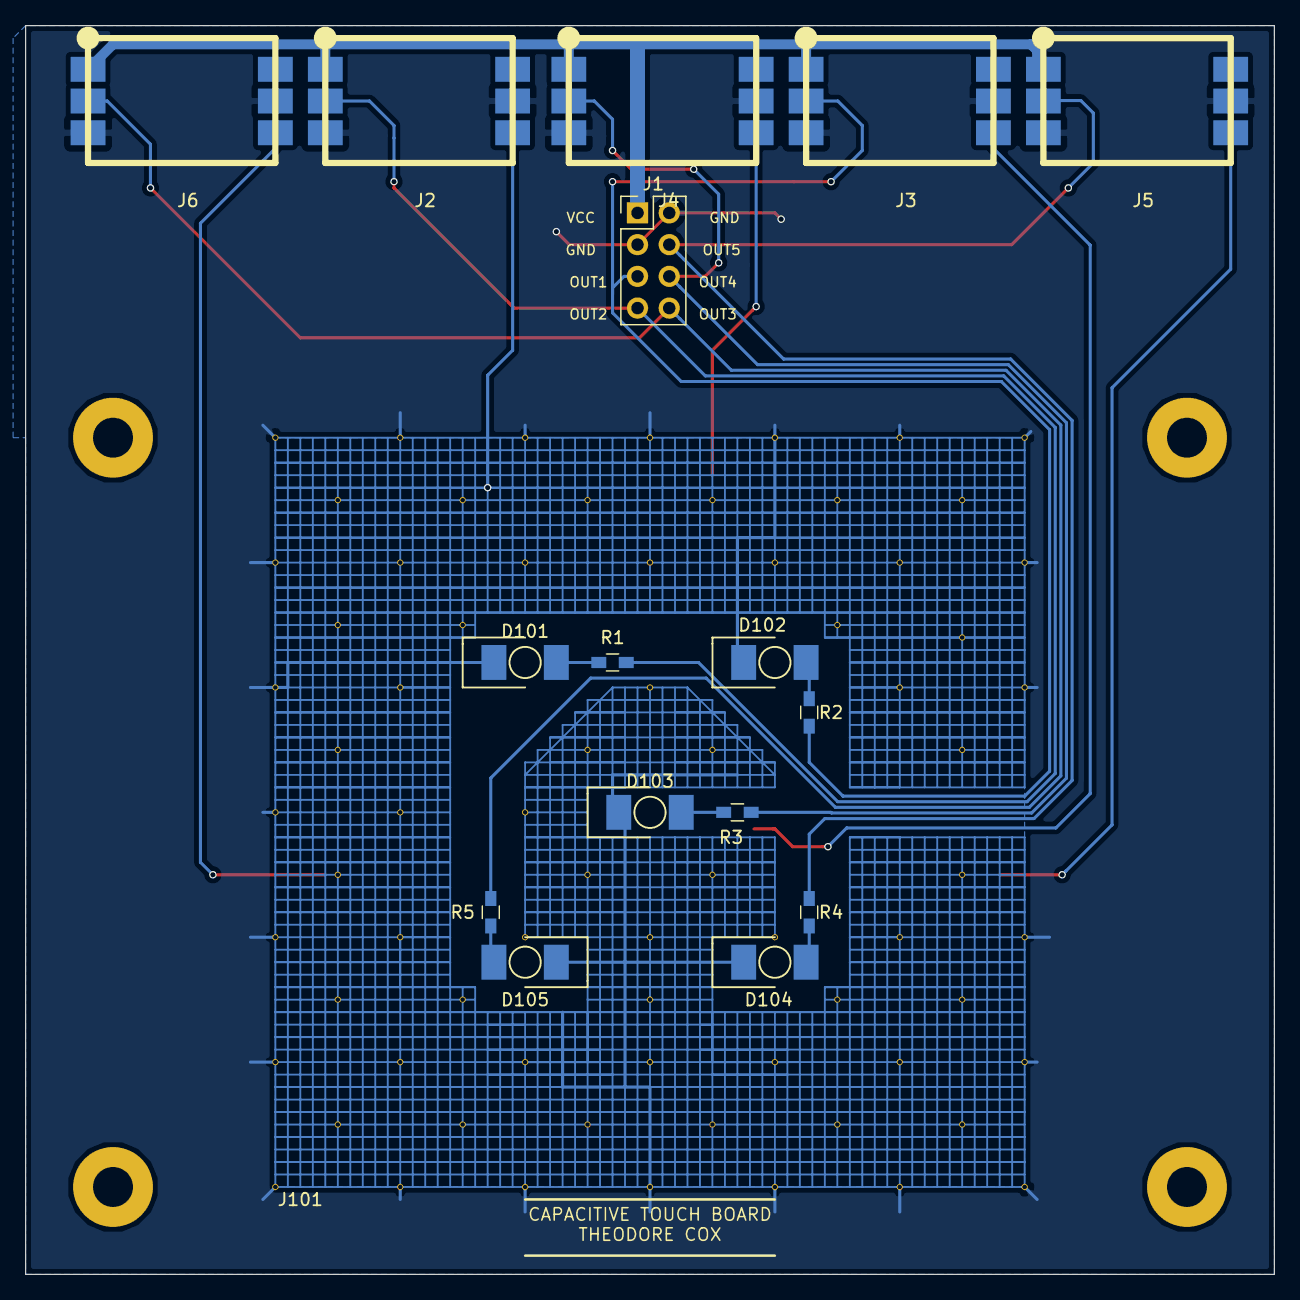
[picture p28: board touchSense.kicad_pcb from below]

Board: 2 copper layers, 100.0 x 100.0 mm, 21 parts (17 on the bottom side), 12 nets.

Parts:
D101, D102, D103, D104, D105: LED; LED_VLRK31Q1R2_REV_GUL
J1: breakout_MainBoard; Pin_Header_Straight_2x04_Pitch2.54mm
J2, J3, J4, J5, J6: CAPTOUC_castellated_Module; CAPTOUCH_castellated
J101: HATCHED_FILL; HATCHED_FILL_60mm_signalRouting
M101, M101#2, M102, M103: Mount; MountingHole_3.2mm_M3_Pad
R1, R2, R3, R4, R5: 500; R_0603_HandSoldering

Connections:
/OUT_1: J1.7, J2.2, R1.2
/OUT_2: J1.5, J3.2, R2.2
/OUT_3: J1.6, J4.2, R3.2
/OUT_4: J1.4, J5.2, R4.2
/OUT_5: J1.8, J6.2, R5.2
/VCC: J1.1, J2.1, J3.1, J4.1, J5.1, J6.1
GND: D101.1, D102.1, D103.1, D104.1, D105.1, J1.2, J1.3, J2.3, J2.5, J3.3, J3.5, J4.3, J4.5, J5.3, J5.5, J6.3, J6.5, J101.1
unnamed: D101.2, R1.1
unnamed: D102.2, R2.1
unnamed: D103.2, R3.1
unnamed: D104.2, R4.1
unnamed: D105.2, R5.1
