bin2ai/Senior_Design/Senior_Design.kicad_pcb

## KiCad design Senior_Design.kicad_pcb (2018-06-17)

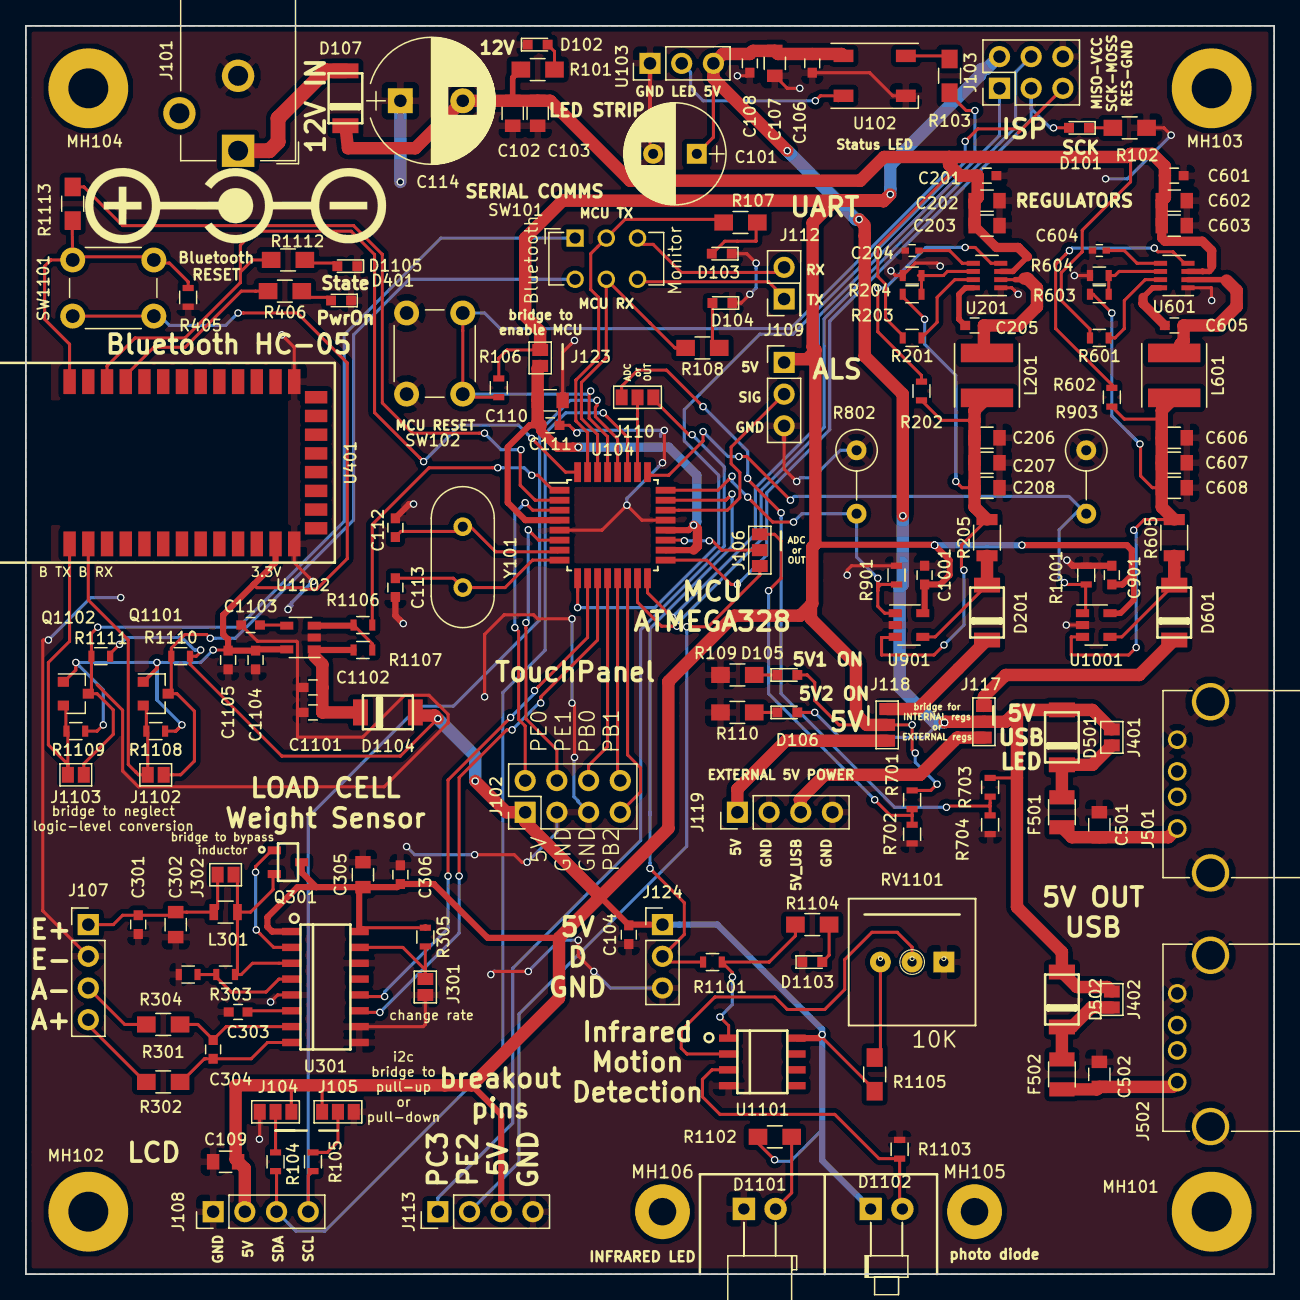
[picture p29: board Senior_Design.kicad_pcb from above]

Board: 2 copper layers, 100.0 x 100.0 mm, 164 parts (0 on the bottom side), 101 nets.

Parts:
C101: ?uF; CP_Radial_D8.0mm_P3.50mm
C102, C103, C107, C109, C110, C202, C203, C302, C305, C501, C502, C602, C603: 10uF; C_0805
C104, C106, C108, C111, C201, C205, C301, C303, C304, C306, C601, C605, C901, C1001, C1101, C1103, C1104: 0.1uF; C_0603
C112, C113: 20pF; C_0603
C114: ?uF; CP_Radial_D10.0mm_P5.00mm
C204, C604: 8200pF; C_0402
C206, C207, C208, C606, C607, C608: 22uF; C_0805
C1102, C1105: 1uF; C_0603
D101, D102, D103, D104, D105, D106, D401, D1103, D1105: LED; LED_0603
D107, D201, D501, D502, D601, D1104: D_Schottky; SOD-128
D1101: IR204A; LED_D5.0mm_Horizontal_O3.81mm_Z3.0mm
D1102: D_Photo; LED_D1.8mm_W1.8mm_H2.4mm_Horizontal_O3.81mm_Z4.9mm
F501, F502: Polyfuse; Fuse_SMD1206_Reflow
J101: BARREL_JACK; Barrel_Jack_CUI_PJ-102AH
J102: touch(8pos) AT42QT1070 STANDALONE; Pin_Header_Straight_2x04_Pitch2.54mm
J103: ISP; Pin_Header_Straight_2x03_Pitch2.54mm
J104, J105, J106, J110, J117, J118: GS3
J107: LoadCell_Conn; Pin_Header_Straight_1x04_Pitch2.54mm
J108: Smraza2004_LCD; Pin_Header_Straight_1x04_Pitch2.54mm
J109: ambientLight; Pin_Header_Straight_1x03_Pitch2.54mm
J112: Serial Monitor; Pin_Header_Straight_2x01_Pitch2.54mm
J113: breakout; Pin_Header_Straight_1x04_Pitch2.54mm
J119: ext_5VPWR; Pin_Header_Straight_1x04_Pitch2.54mm
J123, J301, J302, J401, J402, J1102, J1103: GS2
J124: ext_Motion; Pin_Header_Straight_1x03_Pitch2.54mm
J501, J502: USB_A
L201, L601: 4.7uH; L_Taiyo-Yuden_MD-5050
L301: 3.3uH; L_0805
MH101, MH102, MH103, MH104: Mounting Hole; MountingHole_3.2mm_M3_Pad
MH105, MH106: IR LIGHT BLOCKER MOUNT; MountingHole_2.2mm_M2_Pad
Q301: MMBT4403; SOT23
Q1101, Q1102: BSS138; SOT-23
R101, R102, R103, R107, R108, R109, R110, R406, R1102, R1104, R1112, R1113: 500; R_0805_HandSoldering
R104, R105, R1107: 100K; R_0603
R106, R201, R601, R701, R702, R703, R704, R1101: 10k; R_0603
R202, R602: 100k; R_0603
R203, R603: 59k; R_0603
R204, R604: 10k_FB; R_0603
R205, R605: 0.1_SHUNT; R_1206
R301, R302, R1105: 100; R_0805_HandSoldering
R303: 20K; R_0603
R304: 8.2K; R_0603
R305, R405, R901, R1001, R1106, R1108, R1109, R1110, R1111: 10K; R_0603
R802, R903: RL; R_Axial_DIN0309_L9.0mm_D3.2mm_P5.08mm_Vertical
R1103: 54.9K; R_0603
RV1101: 10K; TSR-3386U
SW101: Serial Switch; SW_CuK_JS202011CQN_DPDT_Straight
SW102: RESET; SW_PUSH_6mm
SW1101: BLE_RESET; SW_PUSH_6mm
U102: WS2812B; LED_WS2812B-PLCC4
U103: WS2812B_STRIP; Pin_Header_Straight_1x03_Pitch2.54mm
U104: ATMEGA328PB-AU; TQFP-32_7x7mm_Pitch0.8mm
U201, U601: TPS563210ADDFT; SOT-23-8
U301: HX711; SOIC16
U401: MOUDLE-BLUETOOTH-HC-05(34P-27X13MM); HC-05
U901, U1001: INA169; SOT-23-5
U1101: LM358_IC; SOIC8
U1102: LP2985-3.3; SOT-23-5
Y101: 16MHZ; Crystal_HC49-U_Vertical

Connections:
5V1_monADC: J106.1, R701.2, R702.1
5V2_monADC: J110.1, R703.2, R704.1
5V-BUS: C104.2, C109.1, C305.2, C306.1, C901.1, C1001.1, D105.2, D1102.1, D1104.2, J102.1, J103.2, J104.3, J105.3, J108.2, J109.1, J113.3, J118.2, J123.2, J124.1, Q301.3, R106.1, R305.1, R701.1, R1102.1, R1105.1, R1110.2, R1111.2, U301.1, U301.16, U901.5, U1001.5, U1101.8
5V-BUS_USBLINE: C101.1, C106.2, C107.2, C108.2, D106.2, D501.2, D502.2, J117.2, J401.1, J402.1, R703.1, U102.1, U103.3
5V_curMon+: C206.1, C207.1, C208.1, L201.2, R202.1, R203.2, R205.2, U901.3
5V_curMon+_USBLINE: C606.1, C607.1, C608.1, L601.2, R602.1, R603.2, R605.2, U1001.3
5V_curMon-: D201.2, R205.1, U901.4
5V_curMon-_USBLINE: D601.2, R605.1, U1001.4
5V_curMon_ADC: R802.2, R901.2, U104.24, U901.1
5V_curMon_USBLINE_ADC: R903.2, R1001.2, U104.25, U1001.1
+12V: C102.1, C103.1, C114.2, C201.1, C202.1, C203.1, C601.1, C602.1, C603.1, D107.1, R101.2, R201.2, R601.2, U201.3, U601.3
/Bluetooth/3_3V: C1104.2, C1105.2, Q1101.1, Q1102.1, R1108.2, R1109.2, SW1101.2, U401.12, U1102.5
/Bluetooth/PwrOn: R406.2, U401.31
/Bluetooth/RX_3v3: J1102.2, Q1101.2, R1108.1, U401.2
/Bluetooth/TX_3v3: J1103.2, Q1102.2, R1109.1, U401.1
/RX: J112.2, SW101.3
/TX: J112.1, SW101.6
/_5V_SYS: D201.1, J118.1
/_5V_USB: D601.1, J117.1
BT_EN: R1106.2, U104.1
BT_KEY: R1113.2, U104.2
BT_STATE: R1112.2, U104.32, U401.32
B_RX: J1103.1, Q1102.3, R1111.1, SW101.1
B_TX: J1102.1, Q1101.3, R1110.1, SW101.4
GND: C101.2, C102.2, C103.2, C104.1, C106.1, C107.1, C108.1, C109.2, C110.1, C111.1, C112.2, C113.2, C114.1, C201.2, C202.2, C203.2, C204.2, C206.2, C207.2, C208.2, C301.2, C302.2, C303.2, C305.1, C306.2, C501.2, C502.2, C601.2, C602.2, C603.2, C604.2, C606.2, C607.2, C608.2, C901.2, C1001.2, C1101.1, C1102.1, C1103.1, C1104.1, C1105.1, D102.1, D103.1, D104.1, D401.1, D1101.1, D1103.1, D1105.1, J101.2, J102.3, J102.5, J103.6, J104.1, J105.1, J107.2, J108.1, J109.3, J113.4, J119.2, J119.4, J124.3, J301.2, J501.4, J501.5, J502.4, J502.5, R102.2, R109.2, R110.2, R204.1, R304.2, R405.1, R604.1, R702.2, R704.2, R802.1, R901.1, R903.1, R1001.1, R1103.2, RV1101.1, SW102.2, U102.3, U103.1, U104.5, U104.21, U201.1, U301.5, U301.9, U301.10, U301.14, U401.13, U401.22, U601.1, U901.2, U1001.2, U1101.4, U1102.2
LEDS_Din: U102.2, U103.2
LED_Din: R103.1, U104.9
MCU_RX: R108.2, SW101.5, U104.30
MCU_TX: R107.2, SW101.2, U104.31
MISO: J103.1, U104.16
MOSI: J103.4, U104.15
Motion_Signal: J124.2, R1101.2, U104.23
unnamed: C110.2, C111.2, J123.1, U104.4, U104.18, U104.20
unnamed: C112.1, U104.7, Y101.2
unnamed: C113.1, U104.8, Y101.1
unnamed: C204.1, U201.5
unnamed: C205.1, U201.8
unnamed: C205.2, L201.1, U201.2
unnamed: C303.1, U301.6
unnamed: C304.1, R301.1, U301.7
unnamed: C304.2, R302.1, U301.8
unnamed: C501.1, F501.2, J501.1
unnamed: C502.1, F502.2, J502.1
unnamed: C604.1, U601.5
unnamed: C605.1, U601.8
unnamed: C605.2, L601.1, U601.2
unnamed: C1101.2, C1102.2, D1104.1, R1107.1, U1102.1
unnamed: C1103.2, U1102.4
unnamed: D101.1, R102.1
unnamed: D102.2, R101.1
unnamed: D103.2, R107.1
unnamed: D104.2, R108.1
unnamed: D105.1, R109.1
unnamed: D106.1, R110.1
unnamed: D107.2, J101.1
unnamed: D401.2, R406.1
unnamed: D501.1, F501.1, J401.2
unnamed: D502.1, F502.1, J402.2
unnamed: D1101.2, R1102.2
unnamed: D1102.2, R1103.1, U1101.3
unnamed: D1103.2, R1104.2
unnamed: D1105.2, R1112.1
unnamed: J104.2, R104.2
unnamed: J105.2, R105.2
unnamed: J106.2, U104.19
unnamed: J110.2, U104.26
unnamed: J117.3, J119.3
unnamed: J118.3, J119.1
unnamed: J301.1, R305.2, U301.15
unnamed: J302.1, L301.2, Q301.2, R303.1, U301.3
unnamed: Q301.1, U301.2
unnamed: R103.2, U102.4
unnamed: R201.1, U201.7
unnamed: R202.2, U201.4
unnamed: R203.1, R204.2, U201.6
unnamed: R303.2, R304.1, U301.4
unnamed: R601.1, U601.7
unnamed: R602.2, U601.4
unnamed: R603.1, R604.2, U601.6
unnamed: R1101.1, R1104.1, U1101.1
unnamed: R1105.2, RV1101.3
unnamed: R1106.1, R1107.2, U1102.3
unnamed: R405.2, R1113.1, SW1101.1, U401.34
unnamed: RV1101.2, U1101.2
RESET: J103.5, R106.2, SW102.1, U104.29
SCALE_A+: J107.4, R302.2
SCALE_A-: J107.3, R301.2
SCALE_DOUT: U104.10, U301.12
SCALE_E+: C301.1, C302.1, J107.1, J302.2, L301.1
SCALE_PD_SCK: U104.11, U301.11
SCK: D101.2, J103.3, U104.17
SCL: J108.4, R105.1, U104.28
SDA: J108.3, R104.1, U104.27
ambientLight: J109.2, U104.22
breakout_1A: J110.3, J113.1
breakout_2A: J106.3, J113.2
touch_1: J102.6, U104.12
touch_2: J102.8, U104.13
touch_3: J102.7, U104.14
touch_4: J102.2, U104.3
touch_5: J102.4, U104.6
