bin2ai/Senior_Design/touchSense_r1.kicad_pcb

## KiCad design touchSense_r1.kicad_pcb (2018-06-10)

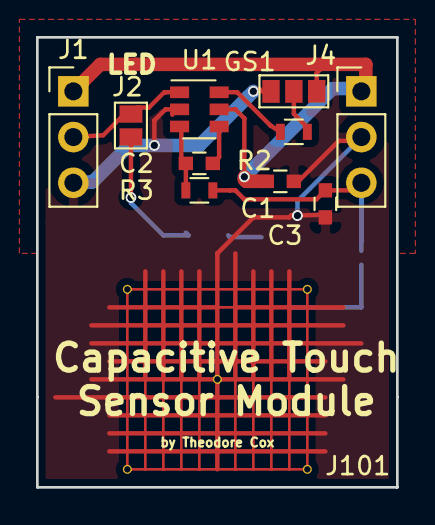
[picture p30: board touchSense_r1.kicad_pcb from above]

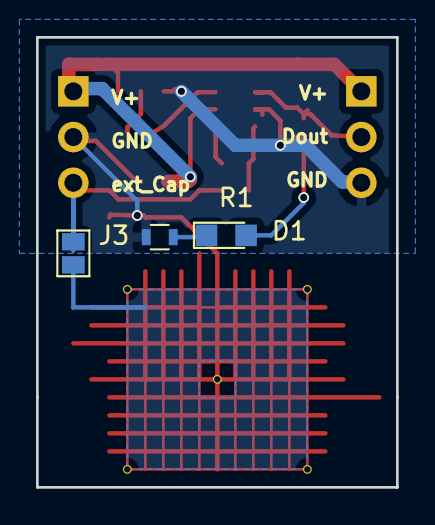
[picture p31: board touchSense_r1.kicad_pcb from below]

Board: 2 copper layers, 20.0 x 25.0 mm, 14 parts (3 on the bottom side), 10 nets.

Parts:
C1: 0.1uF; C_0603
C2: 4.7nF; C_0603
C3: 5pF; C_0603
D1: LED; LED_0805
GS1: GS3
J1: breakout; Pin_Header_Straight_1x03_Pitch2.54mm
J2, J3: GS2
J4: cap/daisy; Pin_Header_Straight_1x03_Pitch2.54mm
J101: Hatched_Fill; HATCHED_FILL_10mm
R1, R2: 1K; R_0603
R3: 10K; R_0603
U1: AT42QT1010-TSHR; SOT-23-6

Connections:
/CAP_PAD: C3.1, J3.1, J4.3, R3.1
/OUT1: J1.2, J2.2, U1.1
/VDD: C1.1, GS1.1, J1.1, J4.1, U1.5
GND: C1.2, C3.2, GS1.3, J1.3, J4.2, J101.1, R1.1, U1.2
unnamed: C2.1, R3.2, U1.3
unnamed: C2.2, U1.4
unnamed: D1.1, R1.2
unnamed: D1.2, J2.1
unnamed: GS1.2, R2.1
unnamed: R2.2, U1.6
