bin2ai/Senior_Design/touchSense_castellatedHoles.kicad_pcb

## KiCad design touchSense_castellatedHoles.kicad_pcb (2018-06-17)

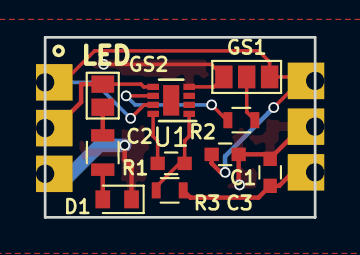
[picture p32: board touchSense_castellatedHoles.kicad_pcb from above]

Board: 2 copper layers, 15.0 x 10.0 mm, 12 parts (0 on the bottom side), 9 nets.

Parts:
C1: 0.1uF; C_0603
C2: 4.7nF; C_0603
C3: 5pF; C_0603
D1: LED_0603_1608Metric
GS1: GS3
GS2: GS2
J1: breakout; CONN_01x03_CastellatedHole_Pad_1mmDrill
J?: CONN_01X03_CASTELLATED; CONN_01x03_CastellatedHole_Pad_1mmDrill
R1: R_0805
R2: 1K; R_0603
R3: 10K; R_0603
U1: VDFN-8-1EP_2x2mm_Pitch0.5mm

Connections:
/CAP_PAD: C3.1, J?.6, R3.1
/OUT1: GS2.2, J1.2, U1.5
/VDD: C1.1, GS1.1, J1.1, J?.4, U1.7
GND: C1.2, C3.2, D1.1, GS1.3, J1.3, J?.5, U1.4
unnamed: C2.1, R3.2, U1.1
unnamed: C2.2, U1.8
unnamed: GS2.1, R1.1
unnamed: GS1.2, R2.1
unnamed: R2.2, U1.6
