bin2ai/Senior_Design/(commit log)

2018-04-23 aded motion sense sheet
    [3_3V-Regulator.sch, 5V-Regulator.sch, AdustKnob.sch, Bluetooth.sch, LoadCell.sch, Senior_Design.sch, USB.sch, motionSense.sch]
2018-04-23 new touch sense schematic
    different part AT42QT1010/1011
    [3_3V-Regulator.sch, 5V-Regulator.sch, AdustKnob.sch, Bluetooth.sch, LoadCell.sch, Senior_Design.sch, TouchSenseSubCircuit.sch, USB.sch]
2018-04-23 changed to ATMEGA2560
    [3_3V-Regulator.sch, 5V-Regulator.sch, Bluetooth.sch, LoadCell.sch, TouchSenseSubCircuit.sch, USB.sch, _saved_Senior_Design.sch, motionSense.sch]
2018-04-23 added usb-serial schematic
    [3_3V-Regulator.sch, 5V-Regulator.sch, Bluetooth.sch, LoadCell.sch, Senior_Design.sch, TouchSenseSubCircuit.sch, USB-Serial.sch, USB.sch]
2018-04-24 added 12V power schematic
    [_saved_Senior_Design.sch]
2018-04-24 created current monitor schematic
    [3_3V-Regulator.sch, 5V-Regulator.sch, Bluetooth.sch, LoadCell.sch, Senior_Design.sch, TouchSenseSubCircuit.sch, USB-Serial.sch, USB.sch]
2018-04-24 current Monitor schematic edit
    [3_3V-Regulator.sch, 5V-Regulator.sch, Bluetooth.sch, LoadCell.sch, Senior_Design.sch, TouchSenseSubCircuit.sch, USB-Serial.sch, USB.sch]
2018-04-24 last edit of the night 4-24
    [3_3V-Regulator.sch, 5V-Regulator.sch, Bluetooth.sch, LoadCell.sch, Senior_Design.sch, TouchSenseSubCircuit.sch, USB-Serial.sch, USB.sch]
2018-04-24 added bom current as of 4-24
    [BOM_4-24.xlsx]
2018-04-24 bom format fix
    [BOM_4-24.xlsx]
2018-04-24 added FTDI chip to bom
    [BOM_4-24.xlsx]
2018-05-13 started PCB layout
    [3_3V-Regulator.sch, 5V-Regulator.sch, Bluetooth.sch, LoadCell.sch, Senior_Design.kicad_pcb, Senior_Design.sch, TouchSenseSubCircuit.sch, USB-Serial.sch]
2018-05-14 hc-05 and buzzer 3d model
    [3_3V-Regulator.sch, 5V-Regulator.sch, Bluetooth.sch, LoadCell.sch, TouchSenseSubCircuit.sch, USB-Serial.sch, USB.sch, VoltageADC.sch]
2018-06-01 after group meeting
    [3_3V-Regulator.sch, 5V-Regulator.sch, Bluetooth.sch, LoadCell.sch, Senior_Design.kicad_pcb, Senior_Design.sch, USB-Serial.sch, USB.sch]
2018-06-05 MCU Change ATMEGA328PB
    [5V-Regulator.sch, ATMEGA328_Pinout_SeniorDesign.xlsx, ATMEGA328_Pinout_SeniorDesign_r1.xlsx, Bluetooth.sch, LoadCell.sch, Senior_Design.kicad_pcb, Senior_Design.sch, USB-Serial.sch]
2018-06-05 all components on board, needs routing
    [5V-Regulator.sch, Bluetooth.sch, LoadCell.sch, Senior_Design.kicad_pcb, Senior_Design.sch, USB.sch, VoltageADC.sch, currentMonitor.sch]
2018-06-06 before meeting
    [5V-Regulator.sch, Senior_Design.kicad_pcb, Senior_Design.sch]
2018-06-07 traces started
    [5V-Regulator.sch, Bluetooth.sch, Cart_Jun07_0343AM.xls, LoadCell.sch, Senior_Design.kicad_pcb, Senior_Design.sch, USB.sch, VoltageADC.sch]
2018-06-08 99 percent ready to order
    [5V-Regulator.sch, BOM_4-24.xlsx, Bluetooth.sch, LoadCell.sch, SeniorDesign_KiCadBom_MouserCart.xls, Senior_Design.csv, Senior_Design.kicad_pcb, Senior_Design.sch]
2018-06-09 finalized pcblayouts, before uploading to manufacturer
    [5V-Regulator.sch, Bluetooth.sch, Senior_Design.kicad_pcb, Senior_Design.sch, TouchSenseSubCircuit.sch, USB.sch, touchSense.kicad_pcb, touchSense.sch]
2018-06-10 new touch implementation
    [5V-Regulator.sch, Bluetooth.sch, Cart_Jun07_0343AM.xls, Cart_Jun09_0148PM.xls, LoadCell.sch, Senior_Design.csv, Senior_Design.kicad_pcb, Senior_Design.sch]
2018-06-10 organize project folder, small pcb maitenance, generated gerbers
    [ATMEGA328_Pinout_SeniorDesign.xlsx, ATMEGA328_Pinout_SeniorDesign_r1.xlsx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]
2018-06-17 after mock cdr
    [Senior_Design-B.Cu.gbr, Senior_Design-B.Mask.gbr, Senior_Design-B.Paste.gbr, Senior_Design-B.SilkS.gbr, Senior_Design-Edge.Cuts.gbr, Senior_Design-F.Cu.gbr, Senior_Design-F.Paste.gbr, Senior_Design-F.SilkS.gbr]
